SoraMause/Novem/Novem/ReadMe.txt

クラッシクマイクロマウス
マシン名　ノヴェム

ハードウェア設計データ
ソフトウェア
