SoraMause/Novem/Novem/cad/electronic/novem.pdf

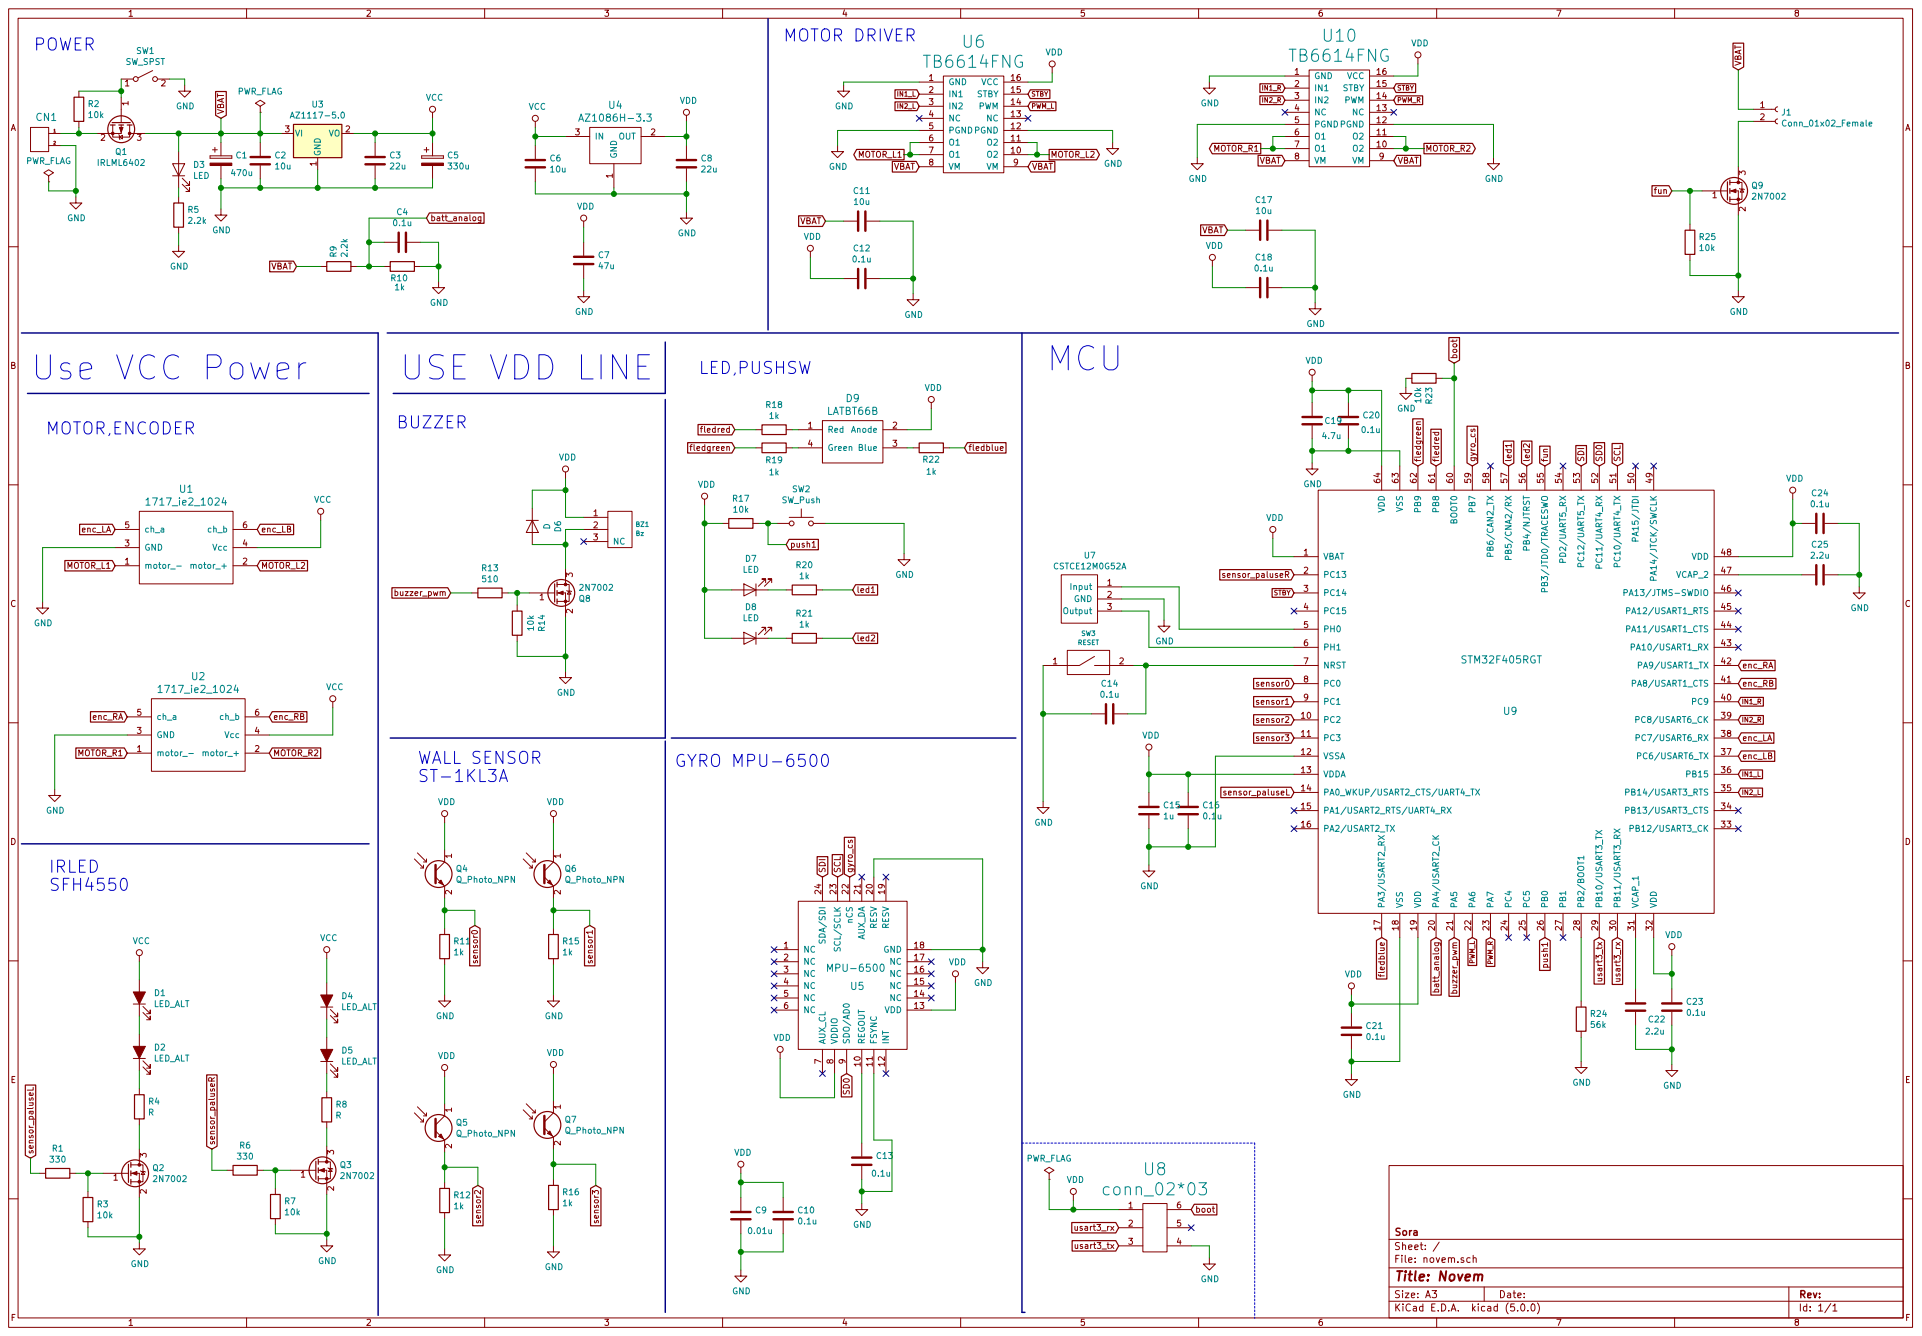
[picture p1: page 1]

File: novem.sch Sheet: / Sora GND

VDD Use VCC Power
