SoraMause/Novem/Novem/cad/electronic/novem.ioc

Mcu.UserName=STM32F405RGTx
PA0-WKUP.GPIO_Label=sensor_paluseL
PA0-WKUP.Signal=GPIO_Output
PA3.GPIO_Label=fled_red
PA3.Signal=GPIO_Output
PA4.Signal=ADCx_IN4
PA5.Signal=S_TIM2_CH1_ETR
PA6.Signal=S_TIM3_CH1
PA7.Signal=S_TIM3_CH2
PA8.Signal=S_TIM1_CH1
PA9.Signal=S_TIM1_CH2
PB0.GPIO_Label=pushsw
PB0.Signal=GPIO_Input
PB10.Signal=USART3_TX
PB11.Signal=USART3_RX
PB14.GPIO_Label=IN2_L
PB14.Signal=GPIO_Output
PB15.GPIO_Label=IN1_L
PB15.Signal=GPIO_Output
PB3.Signal=S_TIM2_CH2
PB4.GPIO_Label=led2
PB4.Signal=GPIO_Output
PB5.GPIO_Label=led1
PB5.Signal=GPIO_Output
PB7.GPIO_Label=gyro_cs
PB7.Signal=GPIO_Output
PB8.GPIO_Label=fledred
PB8.Signal=GPIO_Output
PB9.GPIO_Label=fledgreen
PB9.Signal=GPIO_Output
PC0.Signal=ADCx_IN10
PC1.Signal=ADCx_IN11
PC10.Signal=SPI3_SCK
PC11.Signal=SPI3_MISO
PC12.Signal=SPI3_MOSI
PC13-ANTI_TAMP.GPIO_Label=sensor_paluseR
PC13-ANTI_TAMP.Signal=GPIO_Output
PC14-OSC32_IN.GPIO_Label=stby
PC14-OSC32_IN.Signal=GPIO_Output
PC2.Signal=ADCx_IN12
PC3.Signal=ADCx_IN13
PC6.Signal=S_TIM8_CH1
PC7.Signal=S_TIM8_CH2
PC8.GPIO_Label=IN2_R
PC8.Signal=GPIO_Output
PC9.GPIO_Label=IN1_R
PC9.Signal=GPIO_Output
PH0-OSC_IN.Signal=RCC_OSC_IN
PH1-OSC_OUT.Signal=RCC_OSC_OUT
