SoraMause/Novem/Novem/program/Src/tim.c

/**
  ******************************************************************************
  * File Name          : TIM.c
  * Description        : This file provides code for the configuration
  *                      of the TIM instances.
  ******************************************************************************
  ** This notice applies to any and all portions of this file
  * that are not between comment pairs USER CODE BEGIN and
  * USER CODE END. Other portions of this file, whether 
  * inserted by the user or by software development tools
  * are owned by their respective copyright owners.
  *
  * COPYRIGHT(c) 2018 STMicroelectronics
  *
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
  ******************************************************************************
  */

/* Includes ------------------------------------------------------------------*/
#include "tim.h"

/* USER CODE BEGIN 0 */
#include "arm_math.h"
#include "config.h"

TIM_MasterConfigTypeDef sMasterConfig;
TIM_OC_InitTypeDef sConfigOC;

static int32_t buzzer_period_buff = 0;

/* USER CODE END 0 */

TIM_HandleTypeDef htim1;
TIM_HandleTypeDef htim2;
TIM_HandleTypeDef htim3;
TIM_HandleTypeDef htim8;

/* TIM1 init function */
void MX_TIM1_Init(void)
{
  TIM_Encoder_InitTypeDef sConfig = {0};
  TIM_MasterConfigTypeDef sMasterConfig = {0};

  htim1.Instance = TIM1;
  htim1.Init.Prescaler = 0;
  htim1.Init.CounterMode = TIM_COUNTERMODE_UP;
  htim1.Init.Period = 65535;
  htim1.Init.ClockDivision = TIM_CLOCKDIVISION_DIV1;
  htim1.Init.RepetitionCounter = 0;
  sConfig.EncoderMode = TIM_ENCODERMODE_TI12;
  sConfig.IC1Polarity = TIM_ICPOLARITY_RISING;
  sConfig.IC1Selection = TIM_ICSELECTION_DIRECTTI;
  sConfig.IC1Prescaler = TIM_ICPSC_DIV1;
  sConfig.IC1Filter = 0;
  sConfig.IC2Polarity = TIM_ICPOLARITY_RISING;
  sConfig.IC2Selection = TIM_ICSELECTION_DIRECTTI;
  sConfig.IC2Prescaler = TIM_ICPSC_DIV1;
  sConfig.IC2Filter = 0;
  if (HAL_TIM_Encoder_Init(&htim1, &sConfig) != HAL_OK)
  {
    Error_Handler();
  }
  sMasterConfig.MasterOutputTrigger = TIM_TRGO_RESET;
  sMasterConfig.MasterSlaveMode = TIM_MASTERSLAVEMODE_DISABLE;
  if (HAL_TIMEx_MasterConfigSynchronization(&htim1, &sMasterConfig) != HAL_OK)
  {
    Error_Handler();
  }

}
/* TIM2 init function */
void MX_TIM2_Init(void)
{
  TIM_MasterConfigTypeDef sMasterConfig = {0};
  TIM_OC_InitTypeDef sConfigOC = {0};

  htim2.Instance = TIM2;
  htim2.Init.Prescaler = 1;
  htim2.Init.CounterMode = TIM_COUNTERMODE_UP;
  htim2.Init.Period = 399;
  htim2.Init.ClockDivision = TIM_CLOCKDIVISION_DIV1;
  if (HAL_TIM_PWM_Init(&htim2) != HAL_OK)
  {
    Error_Handler();
  }
  sMasterConfig.MasterOutputTrigger = TIM_TRGO_RESET;
  sMasterConfig.MasterSlaveMode = TIM_MASTERSLAVEMODE_DISABLE;
  if (HAL_TIMEx_MasterConfigSynchronization(&htim2, &sMasterConfig) != HAL_OK)
  {
    Error_Handler();
  }
  sConfigOC.OCMode = TIM_OCMODE_PWM1;
  sConfigOC.Pulse = 0;
  sConfigOC.OCPolarity = TIM_OCPOLARITY_HIGH;
  sConfigOC.OCFastMode = TIM_OCFAST_DISABLE;
  if (HAL_TIM_PWM_ConfigChannel(&htim2, &sConfigOC, TIM_CHANNEL_1) != HAL_OK)
  {
    Error_Handler();
  }
  if (HAL_TIM_PWM_ConfigChannel(&htim2, &sConfigOC, TIM_CHANNEL_2) != HAL_OK)
  {
    Error_Handler();
  }
  HAL_TIM_MspPostInit(&htim2);

}
/* TIM3 init function */
void MX_TIM3_Init(void)
{
  TIM_MasterConfigTypeDef sMasterConfig = {0};
  TIM_OC_InitTypeDef sConfigOC = {0};

  htim3.Instance = TIM3;
  htim3.Init.Prescaler = 1;
  htim3.Init.CounterMode = TIM_COUNTERMODE_UP;
  htim3.Init.Period = 399;
  htim3.Init.ClockDivision = TIM_CLOCKDIVISION_DIV1;
  if (HAL_TIM_PWM_Init(&htim3) != HAL_OK)
  {
    Error_Handler();
  }
  sMasterConfig.MasterOutputTrigger = TIM_TRGO_RESET;
  sMasterConfig.MasterSlaveMode = TIM_MASTERSLAVEMODE_DISABLE;
  if (HAL_TIMEx_MasterConfigSynchronization(&htim3, &sMasterConfig) != HAL_OK)
  {
    Error_Handler();
  }
  sConfigOC.OCMode = TIM_OCMODE_PWM1;
  sConfigOC.Pulse = 0;
  sConfigOC.OCPolarity = TIM_OCPOLARITY_HIGH;
  sConfigOC.OCFastMode = TIM_OCFAST_DISABLE;
  if (HAL_TIM_PWM_ConfigChannel(&htim3, &sConfigOC, TIM_CHANNEL_1) != HAL_OK)
  {
    Error_Handler();
  }
  if (HAL_TIM_PWM_ConfigChannel(&htim3, &sConfigOC, TIM_CHANNEL_2) != HAL_OK)
  {
    Error_Handler();
  }
  HAL_TIM_MspPostInit(&htim3);

}
/* TIM8 init function */
void MX_TIM8_Init(void)
{
  TIM_Encoder_InitTypeDef sConfig = {0};
  TIM_MasterConfigTypeDef sMasterConfig = {0};

  htim8.Instance = TIM8;
  htim8.Init.Prescaler = 0;
  htim8.Init.CounterMode = TIM_COUNTERMODE_UP;
  htim8.Init.Period = 65535;
  htim8.Init.ClockDivision = TIM_CLOCKDIVISION_DIV1;
  htim8.Init.RepetitionCounter = 0;
  sConfig.EncoderMode = TIM_ENCODERMODE_TI12;
  sConfig.IC1Polarity = TIM_ICPOLARITY_RISING;
  sConfig.IC1Selection = TIM_ICSELECTION_DIRECTTI;
  sConfig.IC1Prescaler = TIM_ICPSC_DIV1;
  sConfig.IC1Filter = 0;
  sConfig.IC2Polarity = TIM_ICPOLARITY_RISING;
  sConfig.IC2Selection = TIM_ICSELECTION_DIRECTTI;
  sConfig.IC2Prescaler = TIM_ICPSC_DIV1;
  sConfig.IC2Filter = 0;
  if (HAL_TIM_Encoder_Init(&htim8, &sConfig) != HAL_OK)
  {
    Error_Handler();
  }
  sMasterConfig.MasterOutputTrigger = TIM_TRGO_RESET;
  sMasterConfig.MasterSlaveMode = TIM_MASTERSLAVEMODE_DISABLE;
  if (HAL_TIMEx_MasterConfigSynchronization(&htim8, &sMasterConfig) != HAL_OK)
  {
    Error_Handler();
  }

}

void HAL_TIM_Encoder_MspInit(TIM_HandleTypeDef* tim_encoderHandle)
{

  GPIO_InitTypeDef GPIO_InitStruct = {0};
  if(tim_encoderHandle->Instance==TIM1)
  {
    /* TIM1 clock enable */
    __HAL_RCC_TIM1_CLK_ENABLE();
  
    __HAL_RCC_GPIOA_CLK_ENABLE();
    /**TIM1 GPIO Configuration    
    PA8     ------> TIM1_CH1
    PA9     ------> TIM1_CH2 
    */
    GPIO_InitStruct.Pin = GPIO_PIN_8|GPIO_PIN_9;
    GPIO_InitStruct.Mode = GPIO_MODE_AF_PP;
    GPIO_InitStruct.Pull = GPIO_NOPULL;
    GPIO_InitStruct.Speed = GPIO_SPEED_FREQ_LOW;
    GPIO_InitStruct.Alternate = GPIO_AF1_TIM1;
    HAL_GPIO_Init(GPIOA, &GPIO_InitStruct);

  }
  else if(tim_encoderHandle->Instance==TIM8)
  {
    /* TIM8 clock enable */
    __HAL_RCC_TIM8_CLK_ENABLE();
  
    __HAL_RCC_GPIOC_CLK_ENABLE();
    /**TIM8 GPIO Configuration    
    PC6     ------> TIM8_CH1
    PC7     ------> TIM8_CH2 
    */
    GPIO_InitStruct.Pin = GPIO_PIN_6|GPIO_PIN_7;
    GPIO_InitStruct.Mode = GPIO_MODE_AF_PP;
    GPIO_InitStruct.Pull = GPIO_NOPULL;
    GPIO_InitStruct.Speed = GPIO_SPEED_FREQ_LOW;
    GPIO_InitStruct.Alternate = GPIO_AF3_TIM8;
    HAL_GPIO_Init(GPIOC, &GPIO_InitStruct);

  }
}

void HAL_TIM_PWM_MspInit(TIM_HandleTypeDef* tim_pwmHandle)
{

  if(tim_pwmHandle->Instance==TIM2)
  {
    /* TIM2 clock enable */
    __HAL_RCC_TIM2_CLK_ENABLE();
  }
  else if(tim_pwmHandle->Instance==TIM3)
  {
    /* TIM3 clock enable */
    __HAL_RCC_TIM3_CLK_ENABLE();
  }
}
void HAL_TIM_MspPostInit(TIM_HandleTypeDef* timHandle)
{

  GPIO_InitTypeDef GPIO_InitStruct = {0};
  if(timHandle->Instance==TIM2)
  {
    __HAL_RCC_GPIOA_CLK_ENABLE();
    __HAL_RCC_GPIOB_CLK_ENABLE();
    /**TIM2 GPIO Configuration    
    PA5     ------> TIM2_CH1
    PB3     ------> TIM2_CH2 
    */
    GPIO_InitStruct.Pin = GPIO_PIN_5;
    GPIO_InitStruct.Mode = GPIO_MODE_AF_PP;
    GPIO_InitStruct.Pull = GPIO_NOPULL;
    GPIO_InitStruct.Speed = GPIO_SPEED_FREQ_LOW;
    GPIO_InitStruct.Alternate = GPIO_AF1_TIM2;
    HAL_GPIO_Init(GPIOA, &GPIO_InitStruct);

    GPIO_InitStruct.Pin = GPIO_PIN_3;
    GPIO_InitStruct.Mode = GPIO_MODE_AF_PP;
    GPIO_InitStruct.Pull = GPIO_NOPULL;
    GPIO_InitStruct.Speed = GPIO_SPEED_FREQ_LOW;
    GPIO_InitStruct.Alternate = GPIO_AF1_TIM2;
    HAL_GPIO_Init(GPIOB, &GPIO_InitStruct);

  }
  else if(timHandle->Instance==TIM3)
  {
  
    __HAL_RCC_GPIOA_CLK_ENABLE();
    /**TIM3 GPIO Configuration    
    PA6     ------> TIM3_CH1
    PA7     ------> TIM3_CH2 
    */
    GPIO_InitStruct.Pin = GPIO_PIN_6|GPIO_PIN_7;
    GPIO_InitStruct.Mode = GPIO_MODE_AF_PP;
    GPIO_InitStruct.Pull = GPIO_NOPULL;
    GPIO_InitStruct.Speed = GPIO_SPEED_FREQ_LOW;
    GPIO_InitStruct.Alternate = GPIO_AF2_TIM3;
    HAL_GPIO_Init(GPIOA, &GPIO_InitStruct);

  }

}

void HAL_TIM_Encoder_MspDeInit(TIM_HandleTypeDef* tim_encoderHandle)
{

  if(tim_encoderHandle->Instance==TIM1)
  {
    /* Peripheral clock disable */
    __HAL_RCC_TIM1_CLK_DISABLE();
  
    /**TIM1 GPIO Configuration    
    PA8     ------> TIM1_CH1
    PA9     ------> TIM1_CH2 
    */
    HAL_GPIO_DeInit(GPIOA, GPIO_PIN_8|GPIO_PIN_9);

  }
  else if(tim_encoderHandle->Instance==TIM8)
  {
    /* Peripheral clock disable */
    __HAL_RCC_TIM8_CLK_DISABLE();
  
    /**TIM8 GPIO Configuration    
    PC6     ------> TIM8_CH1
    PC7     ------> TIM8_CH2 
    */
    HAL_GPIO_DeInit(GPIOC, GPIO_PIN_6|GPIO_PIN_7);

  }
}

void HAL_TIM_PWM_MspDeInit(TIM_HandleTypeDef* tim_pwmHandle)
{

  if(tim_pwmHandle->Instance==TIM2)
  {
    /* Peripheral clock disable */
    __HAL_RCC_TIM2_CLK_DISABLE();
  }
  else if(tim_pwmHandle->Instance==TIM3)
  {
    /* Peripheral clock disable */
    __HAL_RCC_TIM3_CLK_DISABLE();
  }
} 

/* USER CODE BEGIN 1 */
void funControl( uint8_t fun_mode )
{
  int32_t pwm = 0;

  if ( fun_mode == FUN_ON ) {
    pwm = 35;
  }

  if ( buzzer_period_buff != 7 ){
    htim2.Instance = TIM2;
    htim2.Init.Prescaler = 7;
    htim2.Init.CounterMode = TIM_COUNTERMODE_UP;
    htim2.Init.ClockDivision = TIM_CLOCKDIVISION_DIV1;
    if (HAL_TIM_PWM_Init(&htim2) != HAL_OK)
    {
      Error_Handler();
    }
    buzzer_period_buff = 7;
  } 

  sConfigOC.OCMode = TIM_OCMODE_PWM1;
  sConfigOC.OCPolarity = TIM_OCPOLARITY_HIGH;
  sConfigOC.OCFastMode = TIM_OCFAST_DISABLE;

  // set duty
  sConfigOC.Pulse = pwm; 
	if (HAL_TIM_PWM_ConfigChannel(&htim2, &sConfigOC, TIM_CHANNEL_2) != HAL_OK){
		Error_Handler();
	}

  // start
	if (HAL_TIM_PWM_Start(&htim2, TIM_CHANNEL_2) != HAL_OK){
		Error_Handler();
	}
}

///////////////////////////////////////////////////////////////////////
// set buzzer pwm 
// [argument] pwm,period (0 ~ 1000)
// [Substitutiong] nothing
// [return] nothing
///////////////////////////////////////////////////////////////////////
void buzzerPwmOut( uint32_t pwm, uint32_t period ) 
{
  if ( buzzer_period_buff != period ){
    htim2.Instance = TIM2;
    htim2.Init.Prescaler = period;
    htim2.Init.CounterMode = TIM_COUNTERMODE_UP;
    htim2.Init.Period = 99;
    htim2.Init.ClockDivision = TIM_CLOCKDIVISION_DIV1;
    if (HAL_TIM_PWM_Init(&htim2) != HAL_OK)
    {
      Error_Handler();
    }
    buzzer_period_buff = period;
  } 


  sConfigOC.OCMode = TIM_OCMODE_PWM1;
  sConfigOC.OCPolarity = TIM_OCPOLARITY_HIGH;
  sConfigOC.OCFastMode = TIM_OCFAST_DISABLE;

  // set duty
  sConfigOC.Pulse = pwm; 
	if (HAL_TIM_PWM_ConfigChannel(&htim2, &sConfigOC, TIM_CHANNEL_1) != HAL_OK){
		Error_Handler();
	}

  // start
	if (HAL_TIM_PWM_Start(&htim2, TIM_CHANNEL_1) != HAL_OK){
		Error_Handler();
	}


}

///////////////////////////////////////////////////////////////////////
// get encoder
// [argument] nothing
// [Substitutiong] encoder varaiavble
// [return] nothing
///////////////////////////////////////////////////////////////////////
void update_encoder( t_enc_value *enc, t_run *left, t_run *right )
{
  float enc_left_omega, enc_right_omega;

  uint16_t enc_l_buff = TIM8->CNT;
  uint16_t enc_r_buff = TIM1->CNT;
  TIM1->CNT = 0;
  TIM8->CNT = 0;

  if( enc_l_buff > 32767 ){
    enc->left = (int16_t)enc_l_buff;
  } else {
    enc->left = enc_l_buff;
  }
  
  if ( enc_r_buff > 32767 ){
    enc->right = -1 * (int16_t)enc_r_buff;
  } else {
    enc->right = -1 * enc_r_buff;
  }

  enc_left_omega = (float)enc->left * 2.0f / MACHINE_ENC_CNT_PER_ROT  * PI / dt ;
  enc_right_omega = (float)enc->right  * 2.0f / MACHINE_ENC_CNT_PER_ROT  * PI / dt;

  left->velocity =  enc_left_omega / dt * MACHINE_WHEEL_RADIUS;
  right->velocity = enc_right_omega / dt * MACHINE_WHEEL_RADIUS;

}

void motorControl( int32_t pwm_l , int32_t pwm_r )
{
  uint32_t pwm_l_buff = 0;
  uint32_t pwm_r_buff = 0;

  sConfigOC.OCMode = TIM_OCMODE_PWM1;
  sConfigOC.OCPolarity = TIM_OCPOLARITY_HIGH;
  sConfigOC.OCFastMode = TIM_OCFAST_DISABLE;

  // TODO 回転方向によって処?��?を変える�??
  // motor l
  if ( pwm_l >= 0 ){
    pwm_l_buff = pwm_l;
    HAL_GPIO_WritePin( IN1_L_GPIO_Port, IN1_L_Pin, GPIO_PIN_RESET );
    HAL_GPIO_WritePin( IN2_L_GPIO_Port, IN2_L_Pin, GPIO_PIN_SET );
  } else {
    pwm_l_buff = -1 * pwm_l;
    HAL_GPIO_WritePin( IN1_L_GPIO_Port, IN1_L_Pin, GPIO_PIN_SET );
    HAL_GPIO_WritePin( IN2_L_GPIO_Port, IN2_L_Pin, GPIO_PIN_RESET );
  }

  // motor_r
  if ( pwm_r >= 0 ){
    pwm_r_buff = pwm_r;
    HAL_GPIO_WritePin( IN1_R_GPIO_Port, IN1_R_Pin, GPIO_PIN_SET );
    HAL_GPIO_WritePin( IN2_R_GPIO_Port, IN2_R_Pin, GPIO_PIN_RESET );
  } else {
    pwm_r_buff = -1 * pwm_r;
    HAL_GPIO_WritePin( IN1_R_GPIO_Port, IN1_R_Pin, GPIO_PIN_RESET );
    HAL_GPIO_WritePin( IN2_R_GPIO_Port, IN2_R_Pin, GPIO_PIN_SET );
  }

  if ( pwm_l_buff > 400 ){
    pwm_l_buff = 399;
  }

  if ( pwm_r_buff > 400 ){
    pwm_r_buff = 399;
  }

  // set duty
  sConfigOC.Pulse = pwm_l_buff; 
  if (HAL_TIM_PWM_ConfigChannel(&htim3, &sConfigOC, TIM_CHANNEL_1) != HAL_OK){
		Error_Handler();
	}

  sConfigOC.Pulse = pwm_r_buff; 
  if (HAL_TIM_PWM_ConfigChannel(&htim3, &sConfigOC, TIM_CHANNEL_2) != HAL_OK){
		Error_Handler();
	}

	if (HAL_TIM_PWM_Start(&htim3, TIM_CHANNEL_1) != HAL_OK){
		Error_Handler();
	}

  if (HAL_TIM_PWM_Start(&htim3, TIM_CHANNEL_2) != HAL_OK){
		Error_Handler();
	}

}


/* USER CODE END 1 */

/************************ (C) COPYRIGHT STMicroelectronics *****END OF FILE****/
