SoraMause/Novem/(commit log)

2018-12-19 set up pid param
2018-12-31 一応走るようになった。これ以前のプログラムに致命的なバグあり
2018-12-31 探索はそれなりに安定,最短走行可能
2018-12-31 斜めのスラロームパラメータを調整しないと走らない。
2019-01-07 最短走行調整中
2019-01-23 check battery voltage
2019-01-26 最短調整中(壁ありなら完走安定してきた)
2019-01-29 調整モード
2019-02-02 最短の壁切れ補正入れた
2019-02-08 吸引時の最短の安定性が上がった
2019-02-16 最短走行一応走る
    [fun.DXF, fun_mounter v2.stl, fun_wheel_etc v8.stl, novemV2.DXF, センサーマウンタ v7.stl, 予備手直し v3.stl]
2019-02-23 ハードウェアのメンテナンスをした
